yurleylopez01-stack/Electromiografo/1769.stp

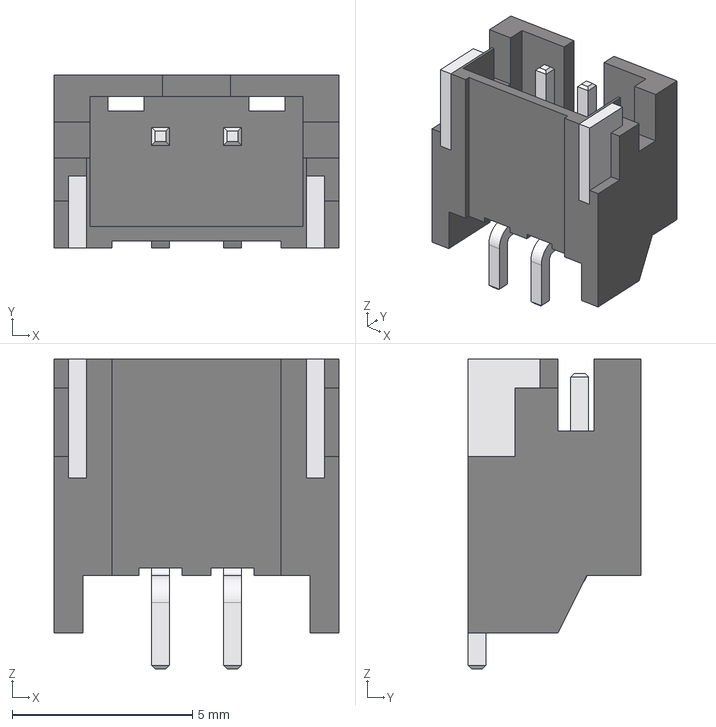
[picture p16: CAD file, 2025-10-23]
1769.stp
7.90 x 4.80 x 8.60 mm
