yurleylopez01-stack/Electromiografo/DATASHET/ENG_CD_1981584_D2.pdf

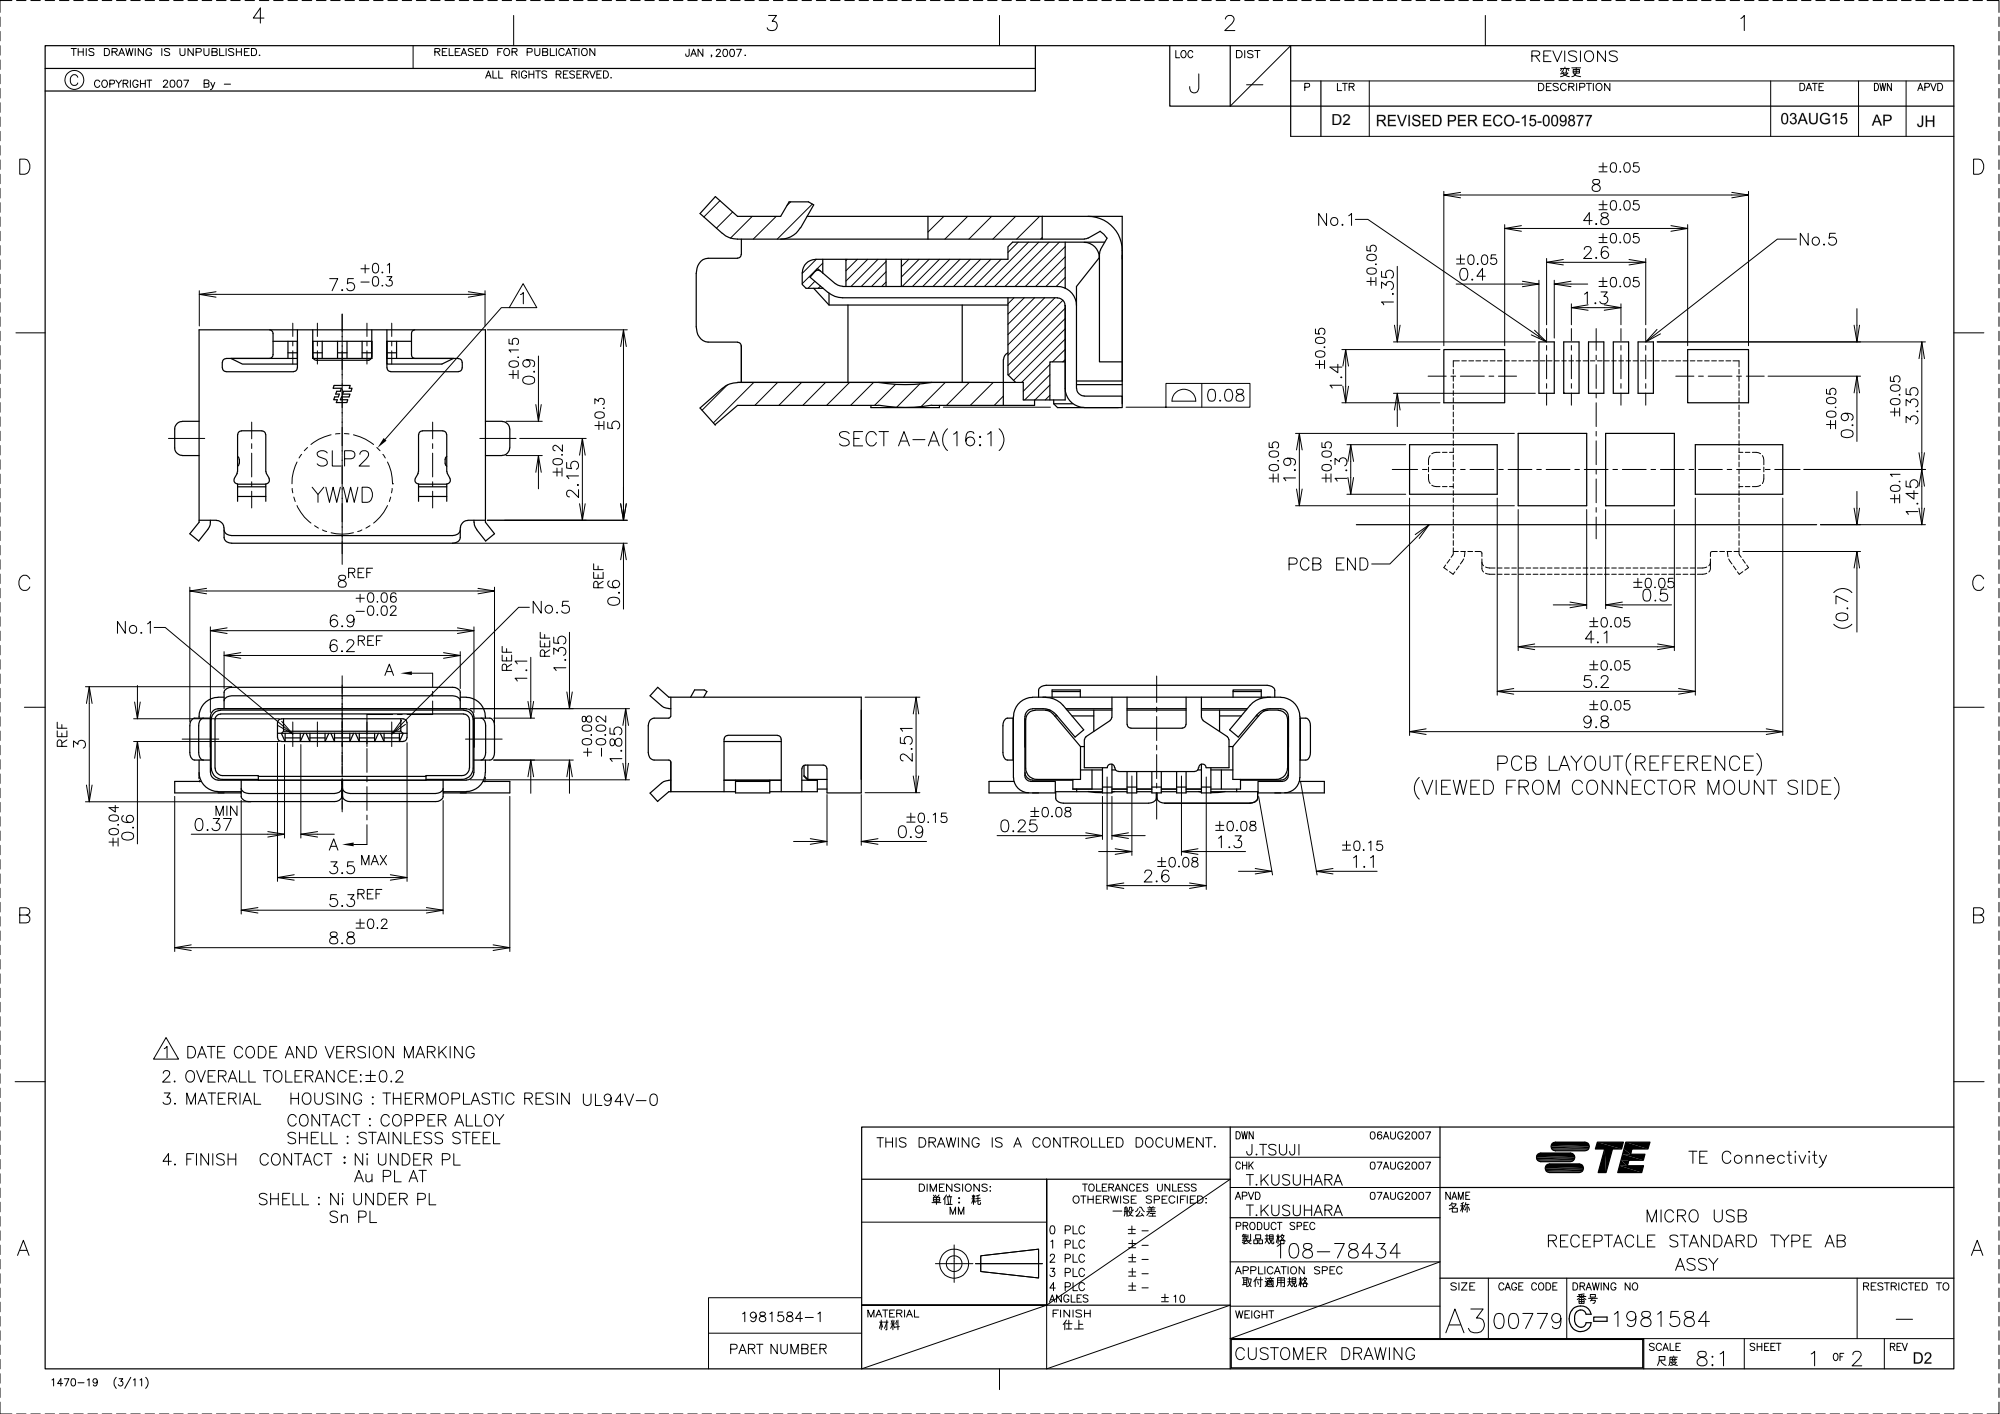
[picture p17: page 1]

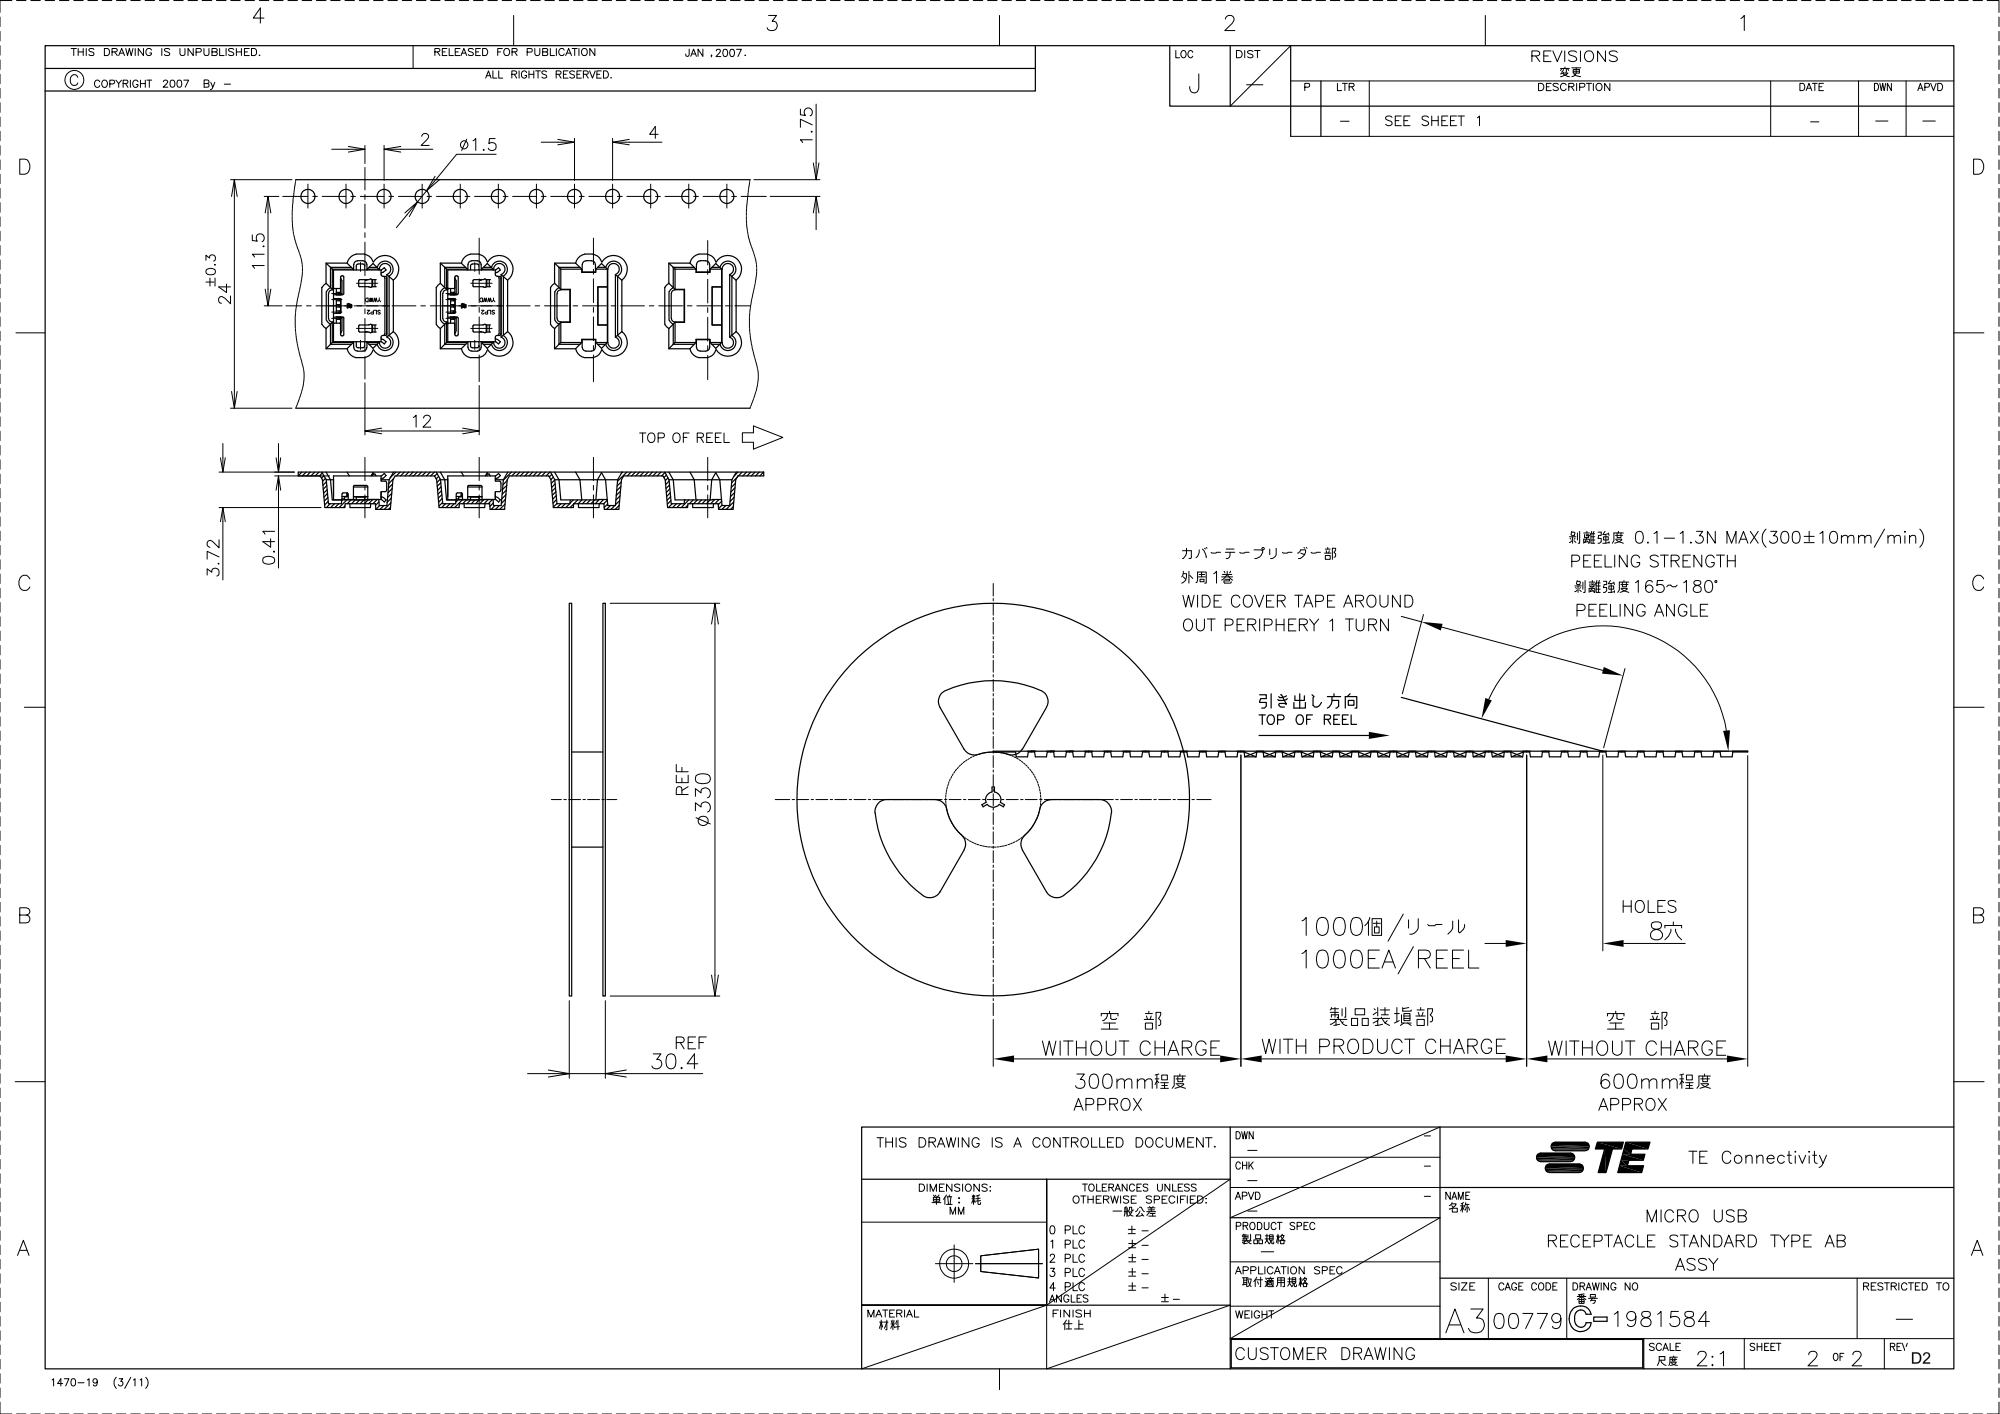
[picture p18: page 2]
