yurleylopez01-stack/Electromiografo/Electromiografo.brd

## EAGLE design Electromiografo.brd (2025-11-05)

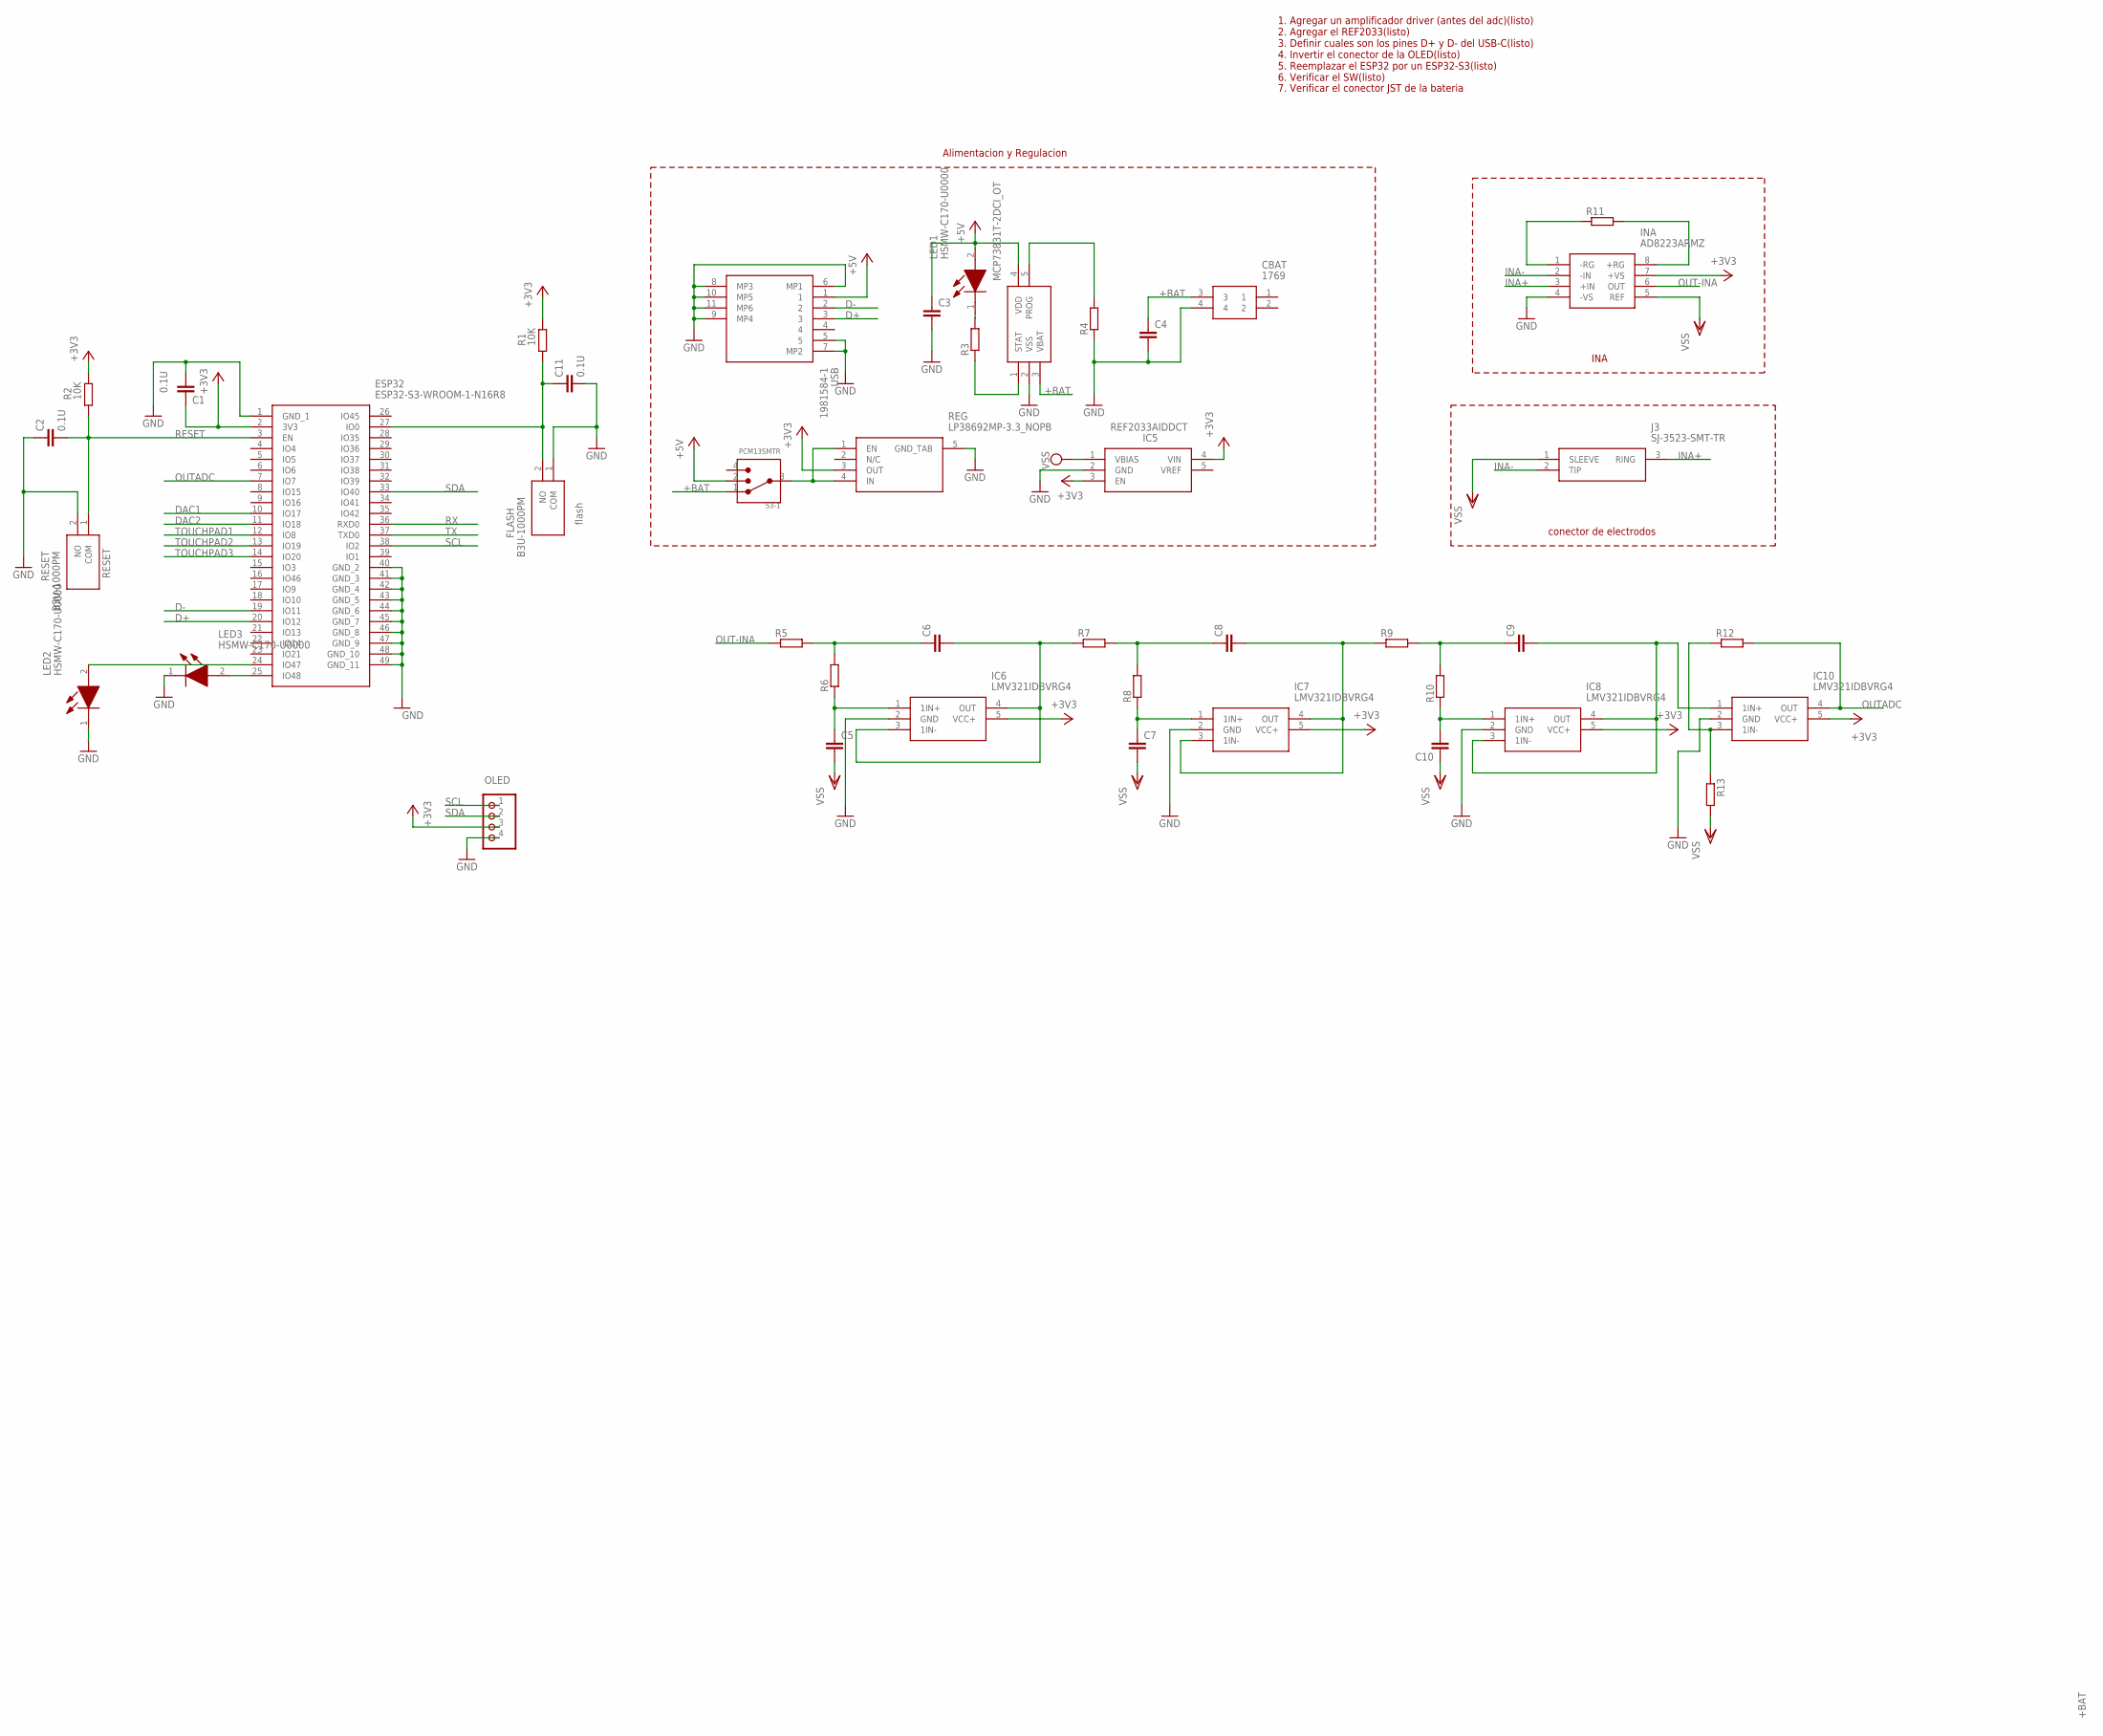
[picture p19: schematic Electromiografo.sch]

Parts:
C1, C2, C11: 0.1U; C0603
C3, C4, C5, C6, C7, C8, C9, C10: C-EUC0805; C0805
CBAT: 1769
ESP32: ESP32-S3-WROOM-1-N16R8; ESP32S3WROOM1N16R8
FLASH: B3U-1000PM; B3U1000PM
IC2: MCP73831T-2DCI_OT; SOT95P270X145-5N
IC5: REF2033AIDDCT; SOT95P280X110-5N
IC6, IC7, IC8, IC10: LMV321IDBVRG4; SOT95P280X145-5N
INA: AD8223ARMZ; SOP65P490X110-8N@1
J3: SJ-3523-SMT-TR; SJ3523SMTTR
JP1: PINHD-1X4/90; 1X04/90
LED1, LED2, LED3: HSMW-C170-U0000; LEDC2012X90N
R1, R2: 10K; R0805
R3, R4, R5, R6, R7, R8, R9, R10, R11, R12, R13: R-EU_R0805; R0805
REG: LP38692MP-3.3_NOPB; SOT150P700X180-5N
RESET: B3U-1000PM; B3U1000PM
S3-1: PCM13SMTR; SW_PCM13SMTR
USB: 1981584-1; 19815841

Connections:
+3V3: C1.2, ESP32.2 (3V3), IC5.4 (VIN), IC6.5 (VCC+), IC7.5 (VCC+), IC8.5 (VCC+), IC10.5 (VCC+), INA.7 (+VS), JP1.3, R1.2, R2.2, REG.3 (OUT)
+5V: C3.1, IC2.4 (VDD), LED1.2 (A), S3-1.2, USB.1
+BAT: C4.1, CBAT.3, IC2.3 (VBAT), S3-1.1
D+: ESP32.20 (IO12), USB.3
D-: ESP32.19 (IO11), USB.2
DAC1: ESP32.10 (IO17)
DAC2: ESP32.11 (IO18)
GND: C1.1, C2.1, C3.2, C4.2, C11.2, CBAT.4, ESP32.1 (GND_1), ESP32.40 (GND_2), ESP32.41 (GND_3), ESP32.42 (GND_4), ESP32.43 (GND_5), ESP32.44 (GND_6), ESP32.45 (GND_7), ESP32.46 (GND_8), ESP32.47 (GND_9), ESP32.48 (GND_10), ESP32.49 (GND_11), FLASH.1 (COM), IC2.2 (VSS), IC5.2 (GND), IC6.2 (GND), IC7.2 (GND), IC8.2 (GND), IC10.2 (GND), INA.4 (-VS), JP1.4, LED2.1 (K), LED3.1 (K), R4.1, REG.5 (GND_TAB), RESET.2 (NO), USB.5, USB.6 (MP1), USB.7 (MP2), USB.8 (MP3), USB.9 (MP4), USB.10 (MP5), USB.11 (MP6)
INA+: INA.3 (+IN), J3.3 (RING)
INA-: INA.2 (-IN), J3.2 (TIP)
unnamed: C11.1, ESP32.27 (IO0), FLASH.2 (NO), R1.1
unnamed: LED1.1 (K), R3.2
unnamed: ESP32.25 (IO48), LED3.2 (A)
unnamed: ESP32.24 (IO47), LED2.2 (A)
unnamed: IC10.3 (1IN-), R12.1, R13.1
unnamed: IC2.1 (STAT), R3.1
unnamed: IC2.5 (PROG), R4.2
unnamed: REG.1 (EN), REG.4 (IN), S3-1.3
unnamed: C6.2, IC6.3 (1IN-), IC6.4 (OUT), R7.1
unnamed: C6.1, R5.2, R6.2
unnamed: C5.1, IC6.1 (1IN+), R6.1
unnamed: C9.1, R9.2, R10.2
unnamed: C7.1, IC7.1 (1IN+), R8.1
unnamed: C8.1, R7.2, R8.2
unnamed: C8.2, IC7.3 (1IN-), IC7.4 (OUT), R9.1
unnamed: C10.2, IC8.1 (1IN+), R10.1
unnamed: C9.2, IC8.3 (1IN-), IC8.4 (OUT), IC10.1 (1IN+)
unnamed: INA.8 (+RG), R11.2
unnamed: INA.1 (-RG), R11.1
OUT-INA: INA.6 (OUT), R5.1
OUTADC: ESP32.7 (IO7), IC10.4 (OUT), R12.2
RESET: C2.2, ESP32.3 (EN), R2.1, RESET.1 (COM)
RX: ESP32.36 (RXD0)
SCL: ESP32.38 (IO2), JP1.1
SDA: ESP32.33 (IO40), JP1.2
TOUCHPAD1: ESP32.12 (IO8)
TOUCHPAD2: ESP32.13 (IO19)
TOUCHPAD3: ESP32.14 (IO20)
TX: ESP32.37 (TXD0)
VSS: C5.2, C7.2, C10.1, IC5.1 (VBIAS), INA.5 (REF), J3.1 (SLEEVE), R13.2

Notes on the sheet:
OLED
conector de electrodos
INA
Alimentacion y Regulacion
1. Agregar un amplificador driver (antes del adc)(listo) 2. Agregar el REF2033(listo) 3. Definir cuales son los pines D+ y D- del USB-C(listo) 4. Invertir el conector de la OLED(listo) 5. Reemplazar el ESP32 por un ESP32-S3(listo) 6. Verificar el SW(listo)
7. Verificar el conector JST de la bateria
flash
RESET

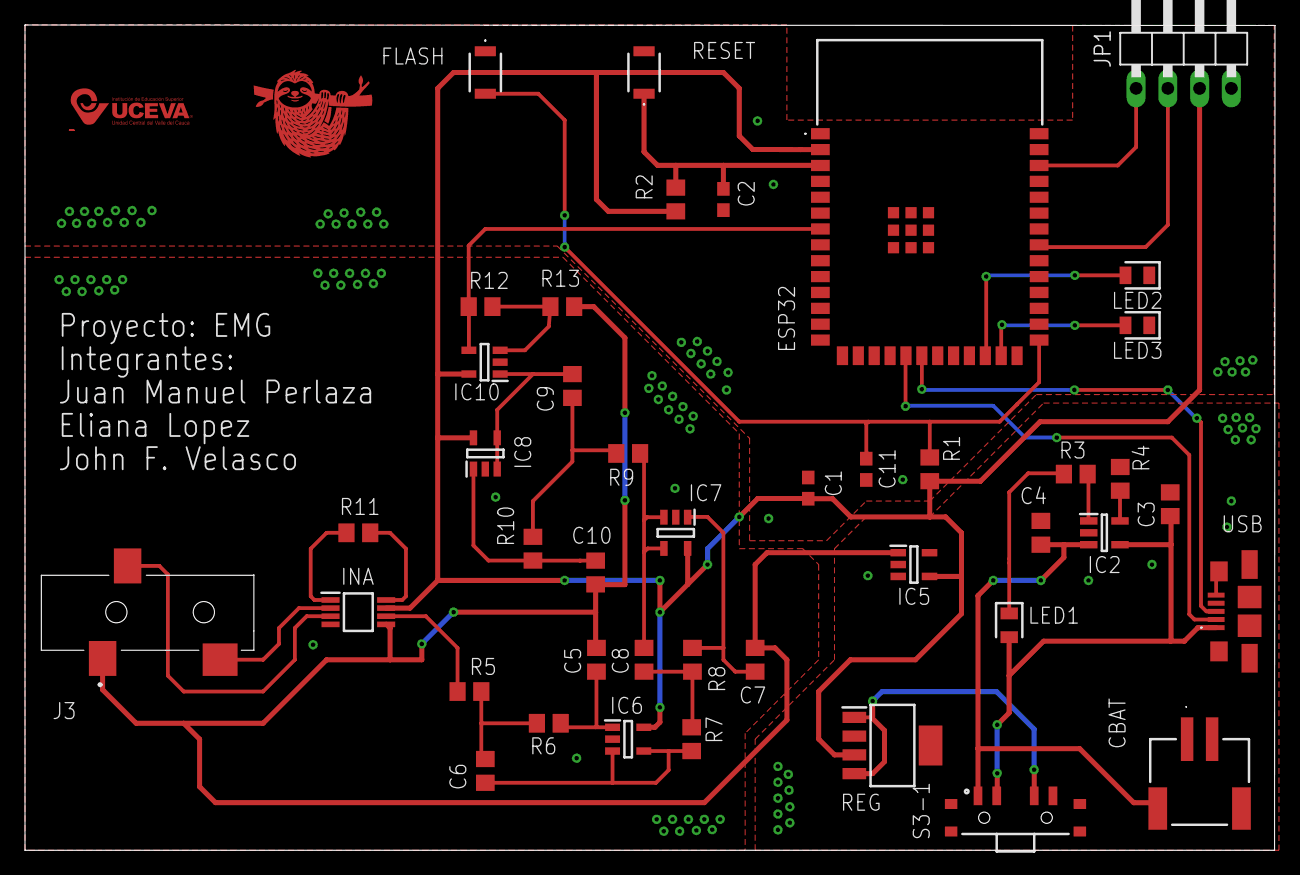
[picture p20: board Electromiografo.brd from above]

Board: 2 copper layers, 100.0 x 66.0 mm, 43 parts (0 on the bottom side), 33 nets.
