yurleylopez01-stack/Electromiografo/(commit log)

2025-10-05 Archivo de prueba
    [Prueba.sch]
2025-10-05 archivo esquematico john
    [Electromiografo.sch]
2025-10-05 Archivo esquematico Eliana - Agregue esquematico de alimentacion, regulacion y voltaje de referencia
    [Electromiografo.sch]
2025-10-05 Archivo de Libreria
2025-10-05 Se agrego el esquematico del filtro pasa bajas y el INA
2025-10-05 Anado el preinforme del proyecto
2025-10-05 Archivo esquematico
    [Electromiografo.sch]
2025-10-06 hojas de datos
2025-10-10 Se corrigio el pin SDA
    [Electromiografo.sch]
2025-10-13 Se añafio anexo de vision y mision
2025-10-17 modificaciones terminadas
    [Electromiografo.brd, Electromiografo.sch]
2025-10-23 Se remplazo conector de bateria
    [Electromiografo.sch]
2025-10-23 Se ubicaron los elementos en la pcb
    [1769.stp, Electromiografo.brd]
2025-10-24 Se ruteo las pistas de INA, Filtro y conector de electrodos
    [Electromiografo.sch]
2025-10-24 modificacion pulsadores
    [Electromiografo.brd, Electromiografo.sch]
2025-10-24 Se rutearon las pistas de alimentacion del pcb
    [Electromiografo.brd, Electromiografo.sch]
2025-10-24 Se termino version uno del pcb
    [Electromiografo.brd]
2025-10-31 corregido el switche
    [Electromiografo.brd, Electromiografo.sch]
2025-10-31 Modificaciones esquematico, version 2 de pcb
    [Electromiografo.brd, Electromiografo.sch]
2025-11-04 Se agrego logotipos a la pcb
    [Electromiografo.brd]
2025-11-04 Se realozaron ajustes finales a la pcb
    [Electromiografo.brd, Electromiografo.sch]
2025-11-05 fix: PCB reviewed
    [Electromiografo.brd]
2025-11-05 Finalizacion de PCB
    [Electromiografo.brd, Electromiografo.sch]
2025-11-25 Se agrego carpeta del codigo
    [copper_bottom.gbr, copper_top.gbr, drill_1_16.xln, gerber_job.gbrjob, profile.gbr, silkscreen_bottom.gbr, silkscreen_top.gbr, soldermask_bottom.gbr]
